Open-Hardware-Leaders/Otto-DIY/_img/portraitOfOtto.jpg

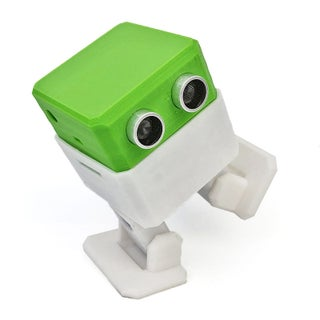
_img/portraitOfOtto.jpg
