Open-Hardware-Leaders/Otto-DIY/Papercraft/OttoDIY_masks_animals_A4.png

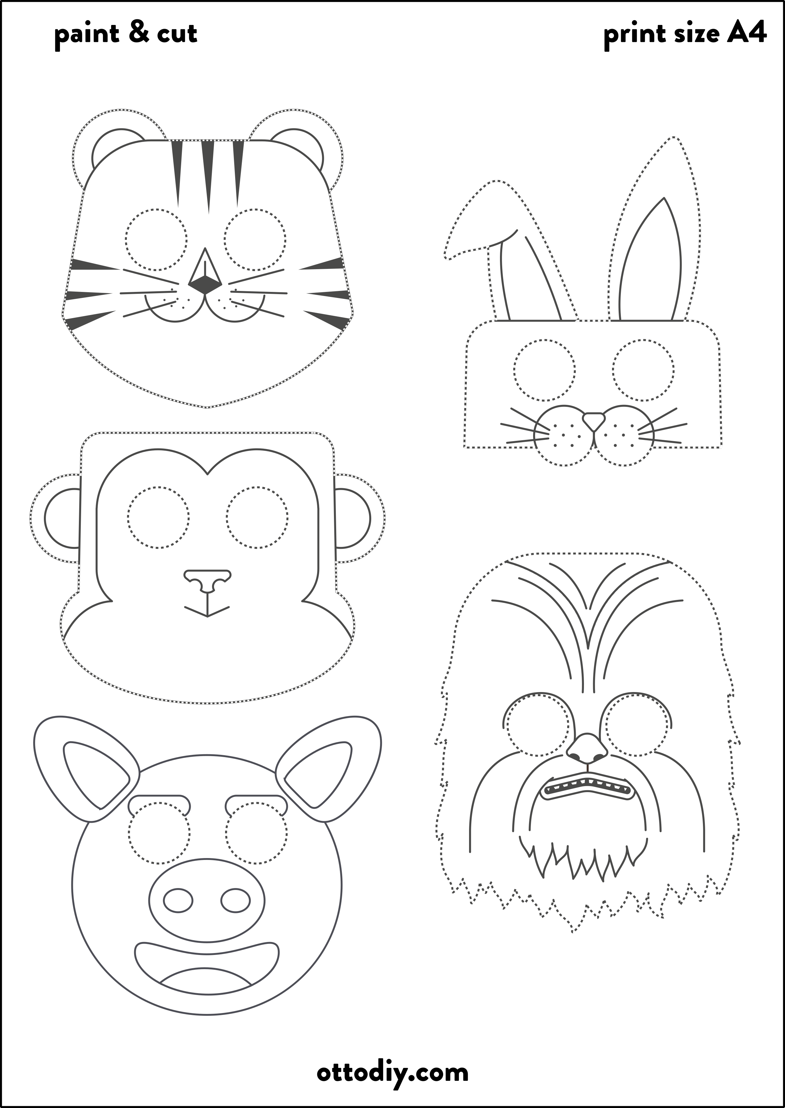
Papercraft/OttoDIY_masks_animals_A4.png
