Open-Hardware-Leaders/Otto-DIY/Papercraft/OttoDIY_masks_king_A4.png

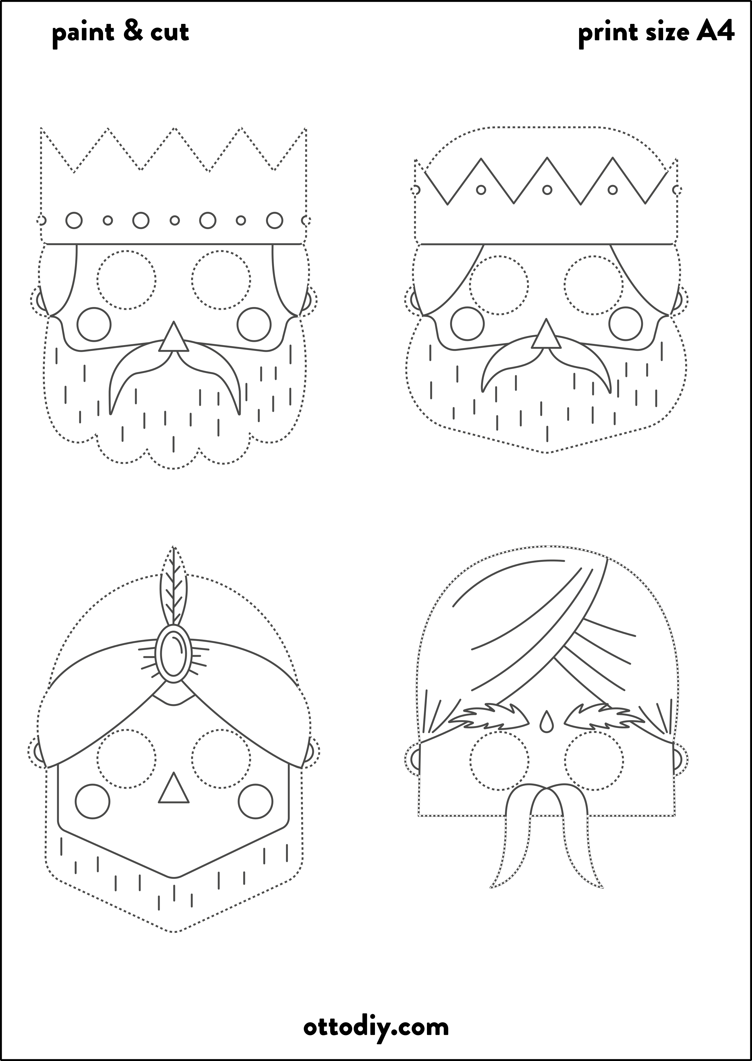
Papercraft/OttoDIY_masks_king_A4.png
