Open-Hardware-Leaders/Otto-DIY/Papercraft/OttoDIY_papercraft_krtek_A4.png

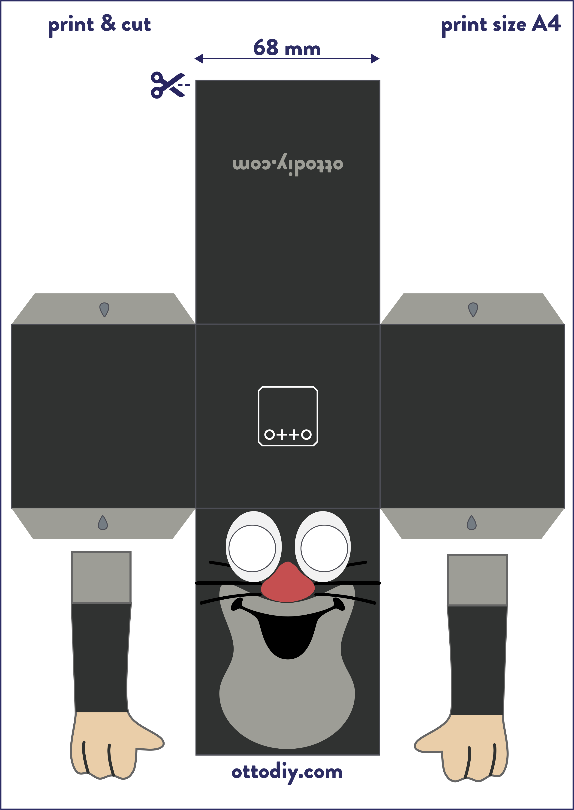
Papercraft/OttoDIY_papercraft_krtek_A4.png
