Open-Hardware-Leaders/Otto-DIY/Papercraft/OttoDIY_papercraft_milkette_A4.png

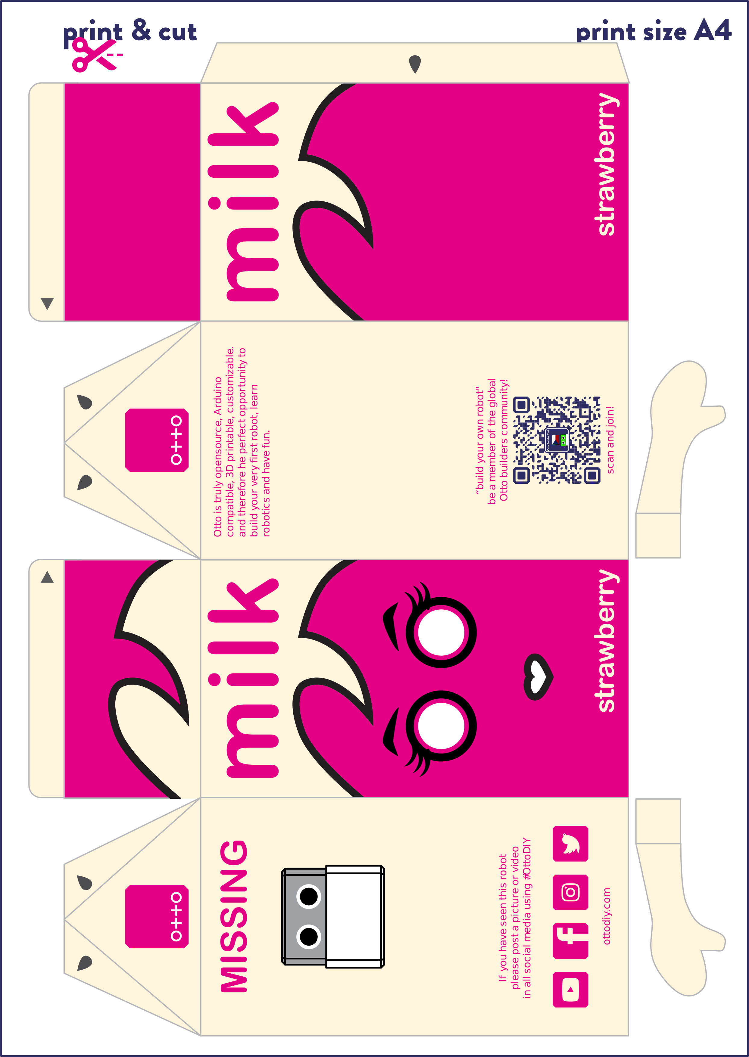
Papercraft/OttoDIY_papercraft_milkette_A4.png
