Open-Hardware-Leaders/Otto-DIY/Papercraft/OttoDIY_papercraft_minion_A4.jpg.png

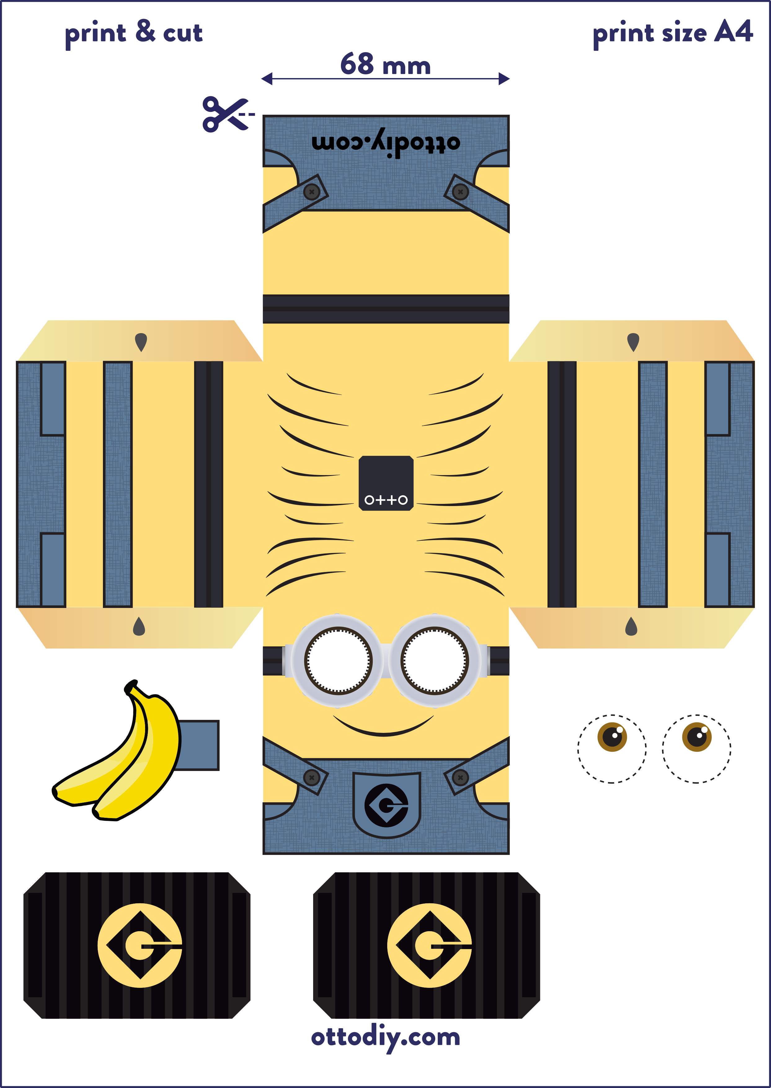
Papercraft/OttoDIY_papercraft_minion_A4.jpg.png
