Open-Hardware-Leaders/Otto-DIY/Papercraft/OttoDIY_papercraft_santa_A4.jpg

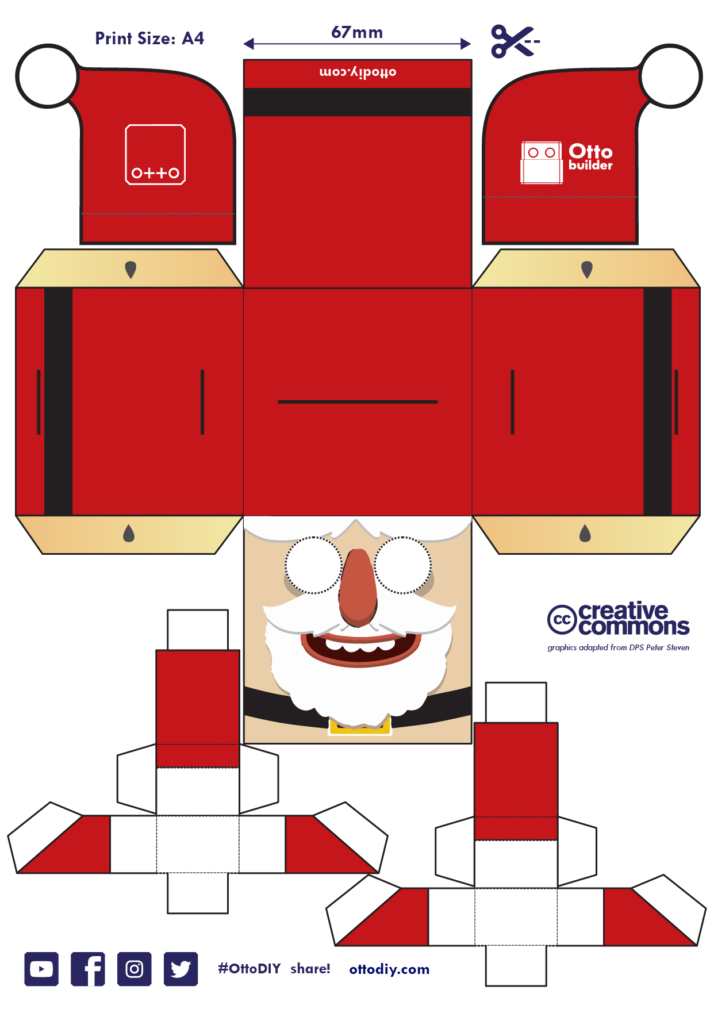
Papercraft/OttoDIY_papercraft_santa_A4.jpg
