Open-Hardware-Leaders/Otto-DIY/Papercraft/OttoDIY_papercraft_stark_A4.jpg

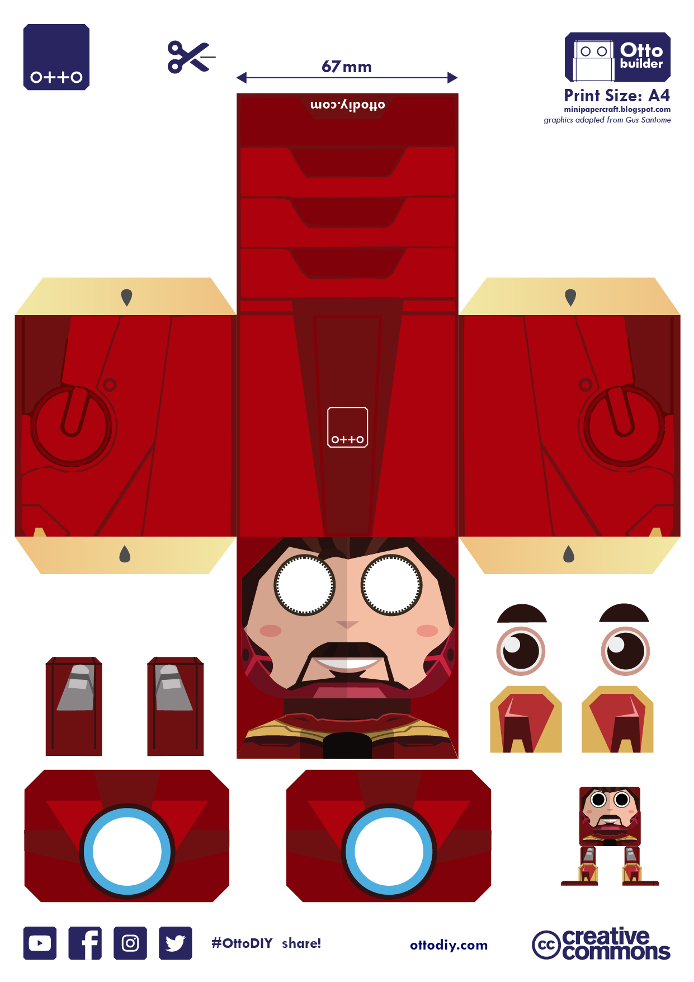
Papercraft/OttoDIY_papercraft_stark_A4.jpg
