Open-Hardware-Leaders/Otto-DIY/Papercraft/OttoDIY_papercraft_totoro_A4.png

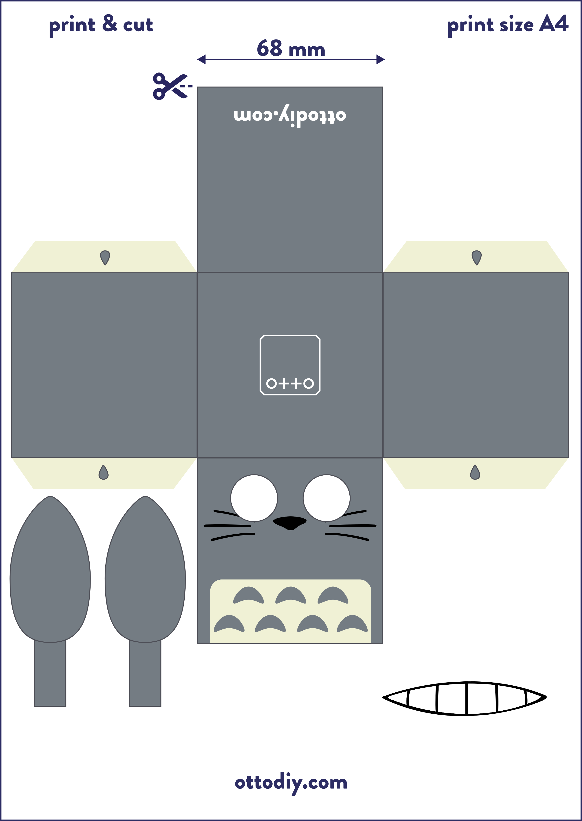
Papercraft/OttoDIY_papercraft_totoro_A4.png
