Open-Hardware-Leaders/Otto-DIY/Papercraft/OttoDIY_paperpaint _milky_A4.png

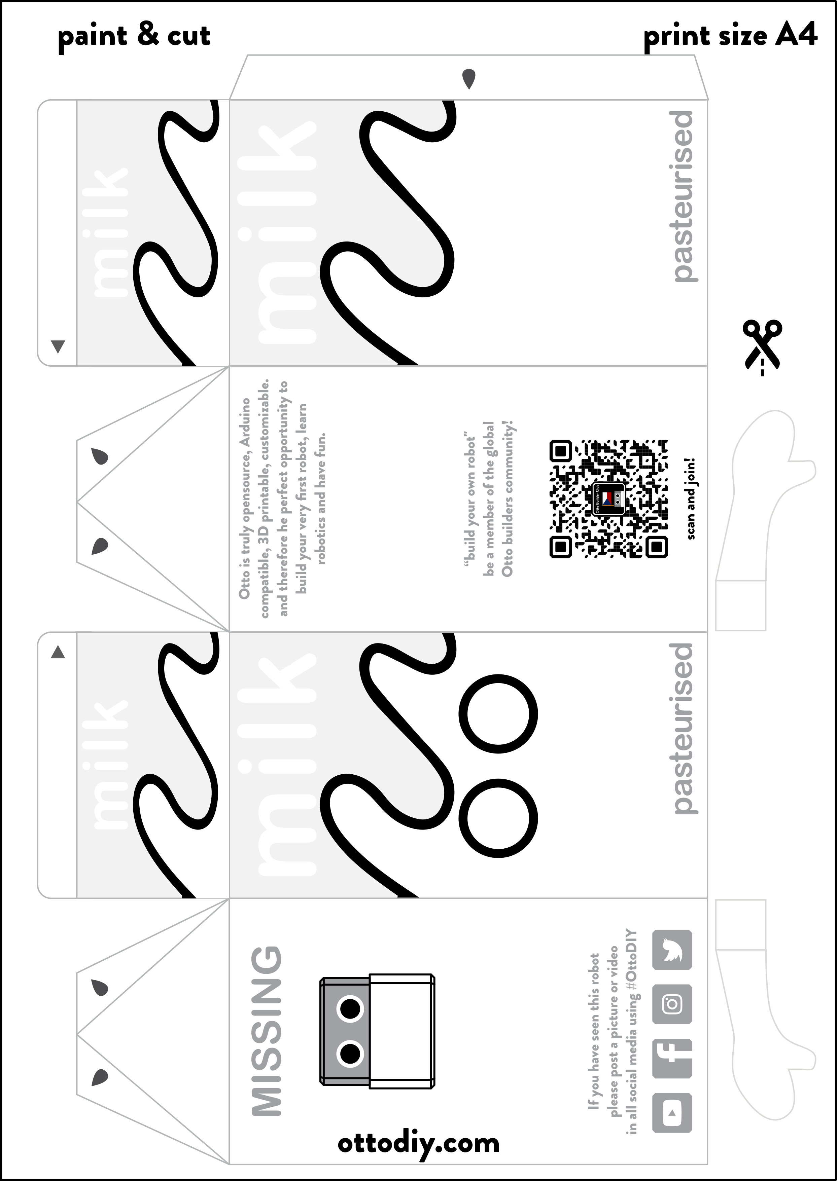
Papercraft/OttoDIY_paperpaint _milky_A4.png
