Open-Hardware-Leaders/Otto-DIY/3Dprint/OttoDIY+_Leg_V9.stl

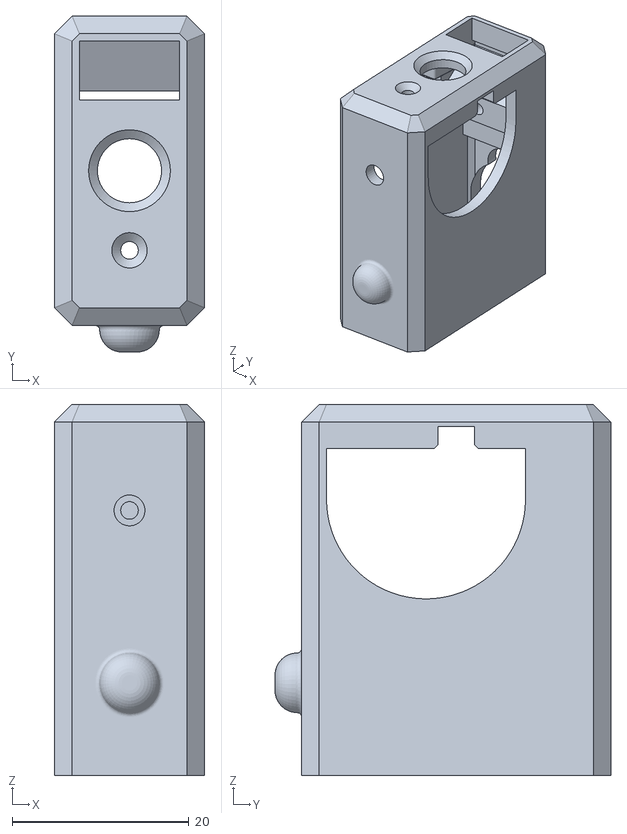
[picture p24: CAD file, 2020-02-19]
3Dprint/OttoDIY+_Leg_V9.stl
17.0 x 38.0 x 42.0
