Open-Hardware-Leaders/Otto-DIY/3Dprint/OttoDIYH_body_V04.stl

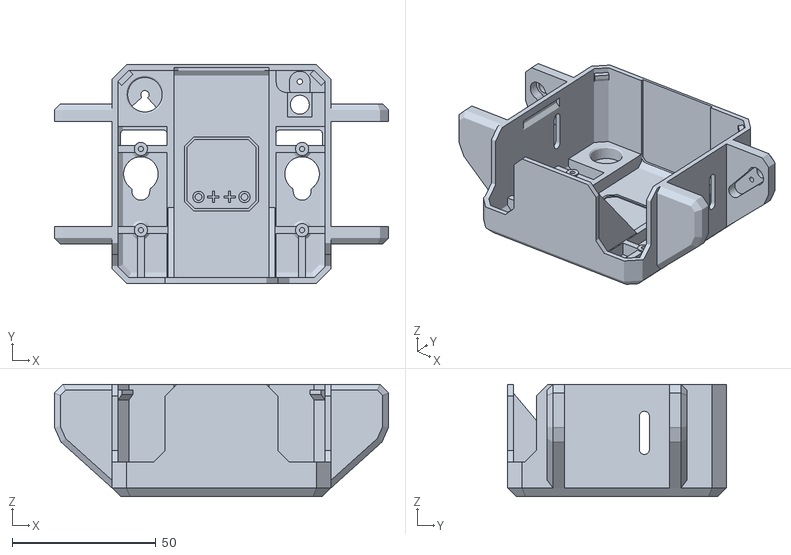
[picture p25: CAD file, 2020-02-19]
3Dprint/OttoDIYH_body_V04.stl
116.0 x 76.0 x 39.0
