Open-Hardware-Leaders/Otto-DIY/3Dprint/OttoDIYEYES_head_V04.stl

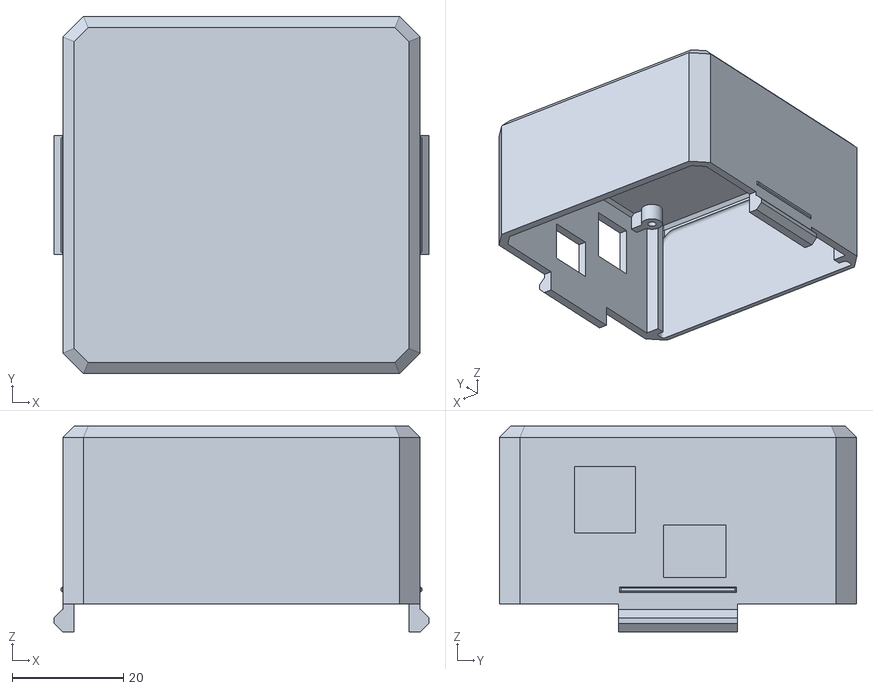
[picture p26: CAD file, 2020-02-19]
3Dprint/OttoDIYEYES_head_V04.stl
67.5 x 64.3 x 37.0
