Open-Hardware-Leaders/Otto-DIY/3Dprint/OttoDIYH_head_v06_PLUG.stl

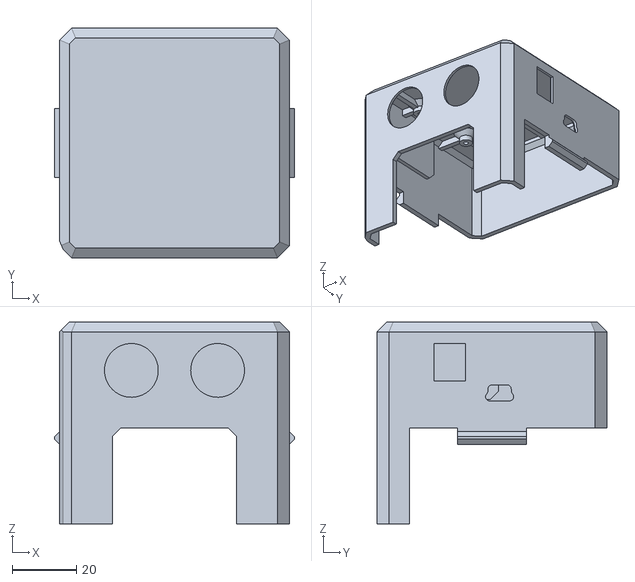
[picture p27: CAD file, 2020-02-19]
3Dprint/OttoDIYH_head_v06_PLUG.stl
74.7 x 71.5 x 62.8
