Open-Hardware-Leaders/Otto-DIY/3Dprint/switch_button_0.5.stl

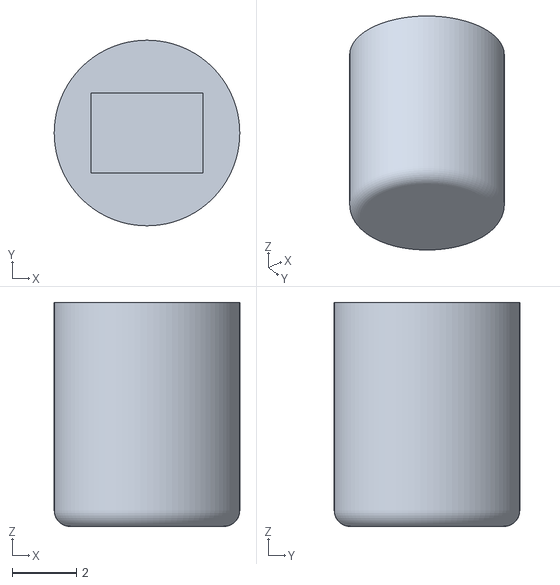
[picture p28: CAD file, 2020-02-19]
3Dprint/switch_button_0.5.stl
5.80 x 5.80 x 7.00
