Open-Hardware-Leaders/Otto-DIY/3Dprint/OttoDIY+_body_V9.stl

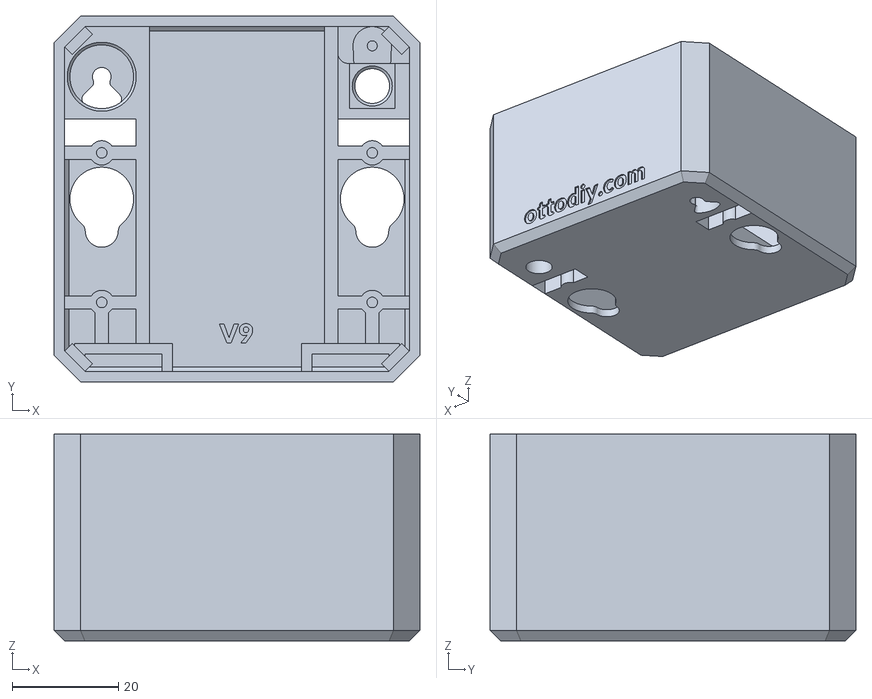
[picture p29: CAD file, 2020-02-19]
3Dprint/OttoDIY+_body_V9.stl
69.0 x 69.0 x 39.0
