Open-Hardware-Leaders/Otto-DIY/3Dprint/OttoDIY+_head_V9.stl

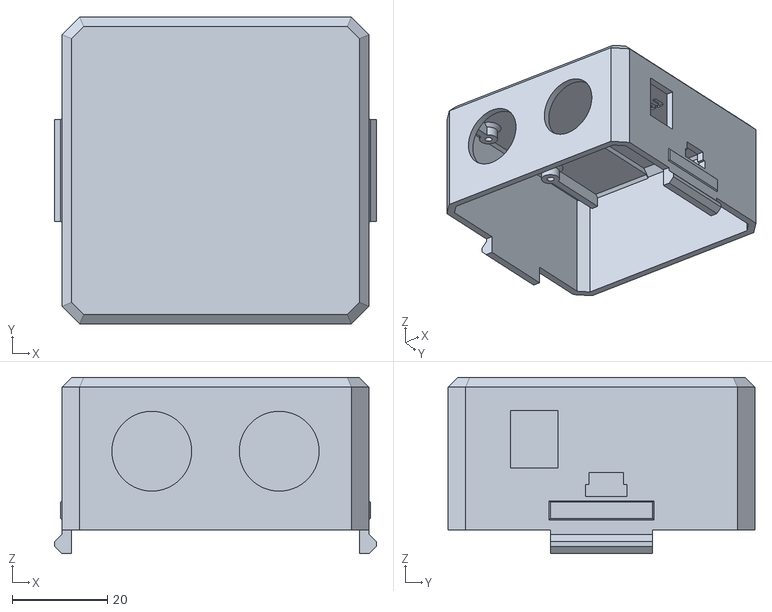
[picture p30: CAD file, 2020-02-19]
3Dprint/OttoDIY+_head_V9.stl
67.6 x 64.4 x 37.0
