Open-Hardware-Leaders/Otto-DIY/3Dprint/OttoDIY+_foot_V9.stl

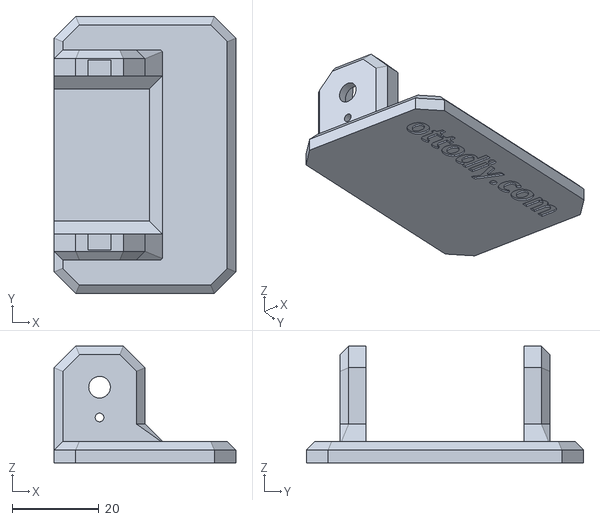
[picture p31: CAD file, 2020-02-19]
3Dprint/OttoDIY+_foot_V9.stl
42.0 x 64.0 x 27.0
