Open-Hardware-Leaders/Otto-DIY/3Dprint/OttoDIYH_grip_V04.stl

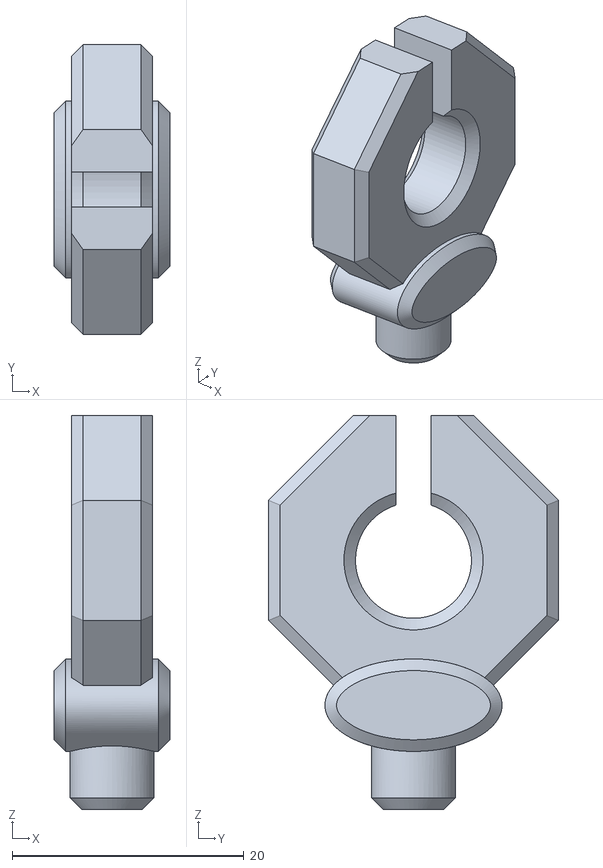
[picture p32: CAD file, 2020-02-19]
3Dprint/OttoDIYH_grip_V04.stl
10.0 x 25.0 x 34.0
