Open-Hardware-Leaders/Otto-DIY/(list of files, cad)

Other CAD files:
CAD/OttoDIY_CUSTOM.scad
CAD/OttoDIY_v09.f3z
