Open-Hardware-Leaders/Otto-DIY/How to guides/how to do a Otto DIY Workshop.pdf

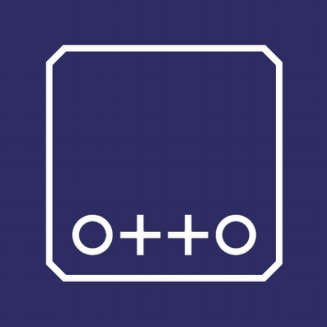
[picture p33: figure]

# Otto DIY workshop

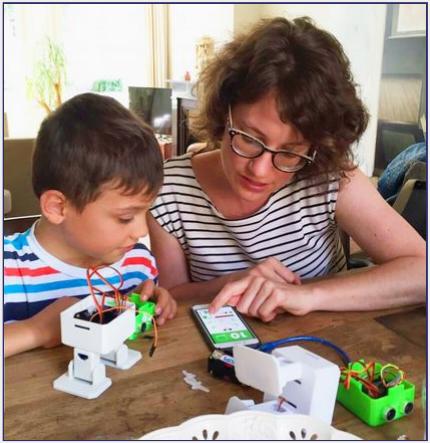
[picture p34: figure]

1) general objectives.
2) pedagogical objectives.

### 3) what do I need to define?

4) list of activities.
5) definition of activities.
6) recommendations.
7) basic use of Otto .

### 8) FAQ (frequently asked questions)

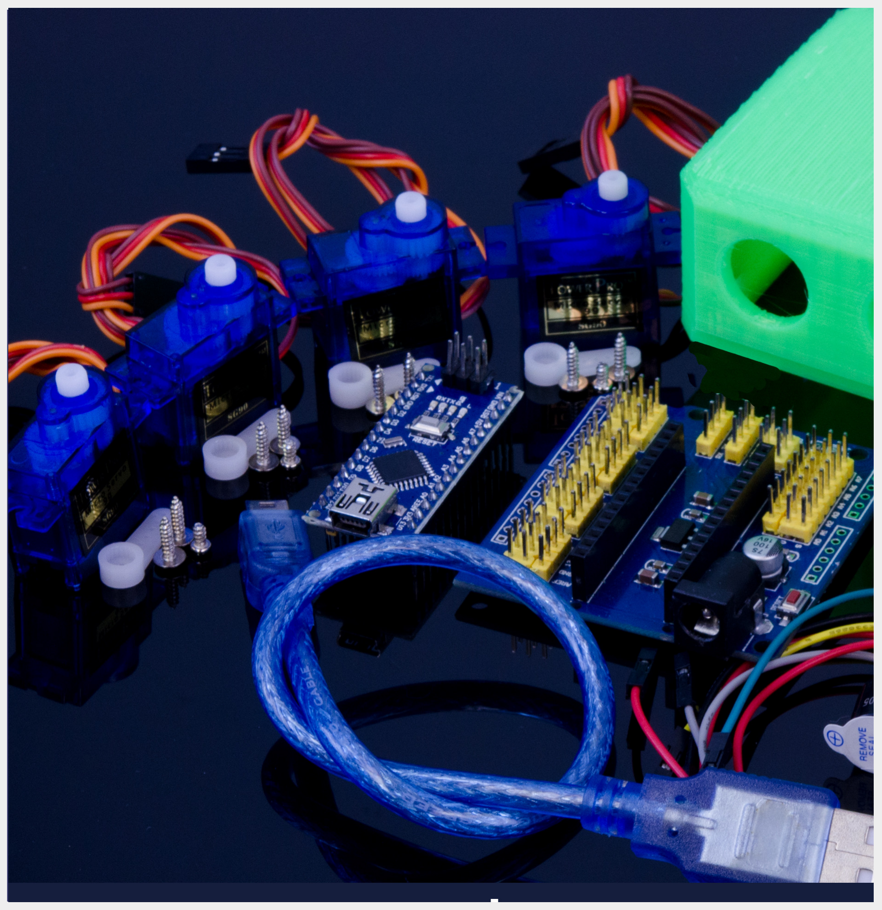
[picture p35: figure]

# general objectives

- increase curiosity about, electronics and products.

### - arouse interest in Otto and its

entertainment possibilities.

### - acquire transverse learning, such as environmental education or discovery of the world through

Otto.

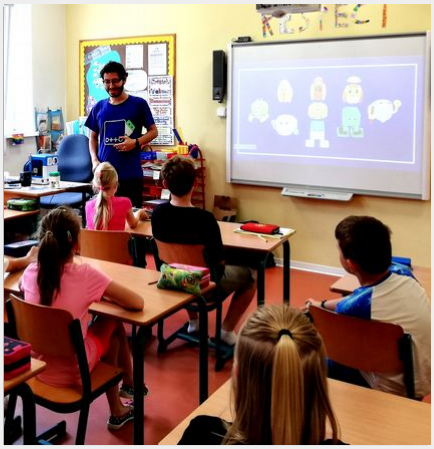
[picture p36: figure]

# pedagogical objectives

- discover Otto's possibilities.
- use educational technology.

### - learn programming with blocks

- improve sequential thinking.

### - brainstorm of improving Otto by

adding more components.
- customize your Otto.

## objectives # participants

## time for preparation

## date age group / level logistic

## robot kits / materials

what do we need to define? | costs

## location

| teachers
| duration
rest and catering | pedagogy

## content

buy robot kits in: ottodiy.com

## list of activities

## ■ intro to the workshop ■ what is a robot? ■ parts of a robot ■ basic concepts ■ build your own robot ■ code your own robot ■ troubleshooting & debugging

## duration

## ■ 5 minutes ■ 10 minutes ■ 10 minutes ■ 15 minutes ■ 60 minutes ■ 15 minutes ■ 5 minutes

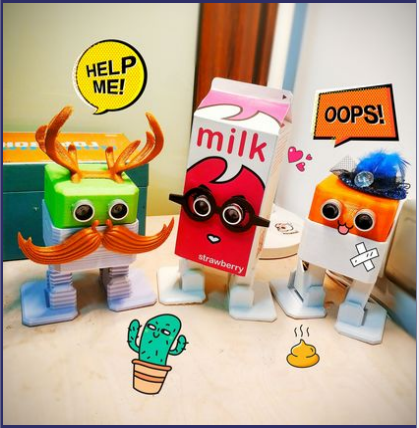
[picture p37: figure]

# definition of activities

### - open question: what is a robot?

- explain what a robot really is.

### - what objects or toys they know are electronic products? - conclusion of what we have

learned about robots.

### - have we changed our point of view?

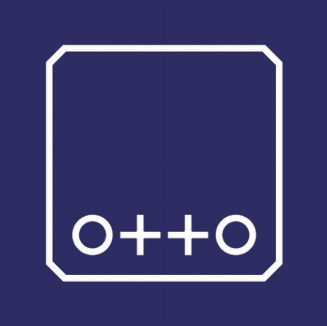
[picture p38: figure]

# what is a robot?

## arm

## car

## Otto

## toy

## truck

## drone

## humanoid cleaner

## space rover

## pet

## plane

## assistant

## machine

Czech word, robota,

# meaning “forced labor”

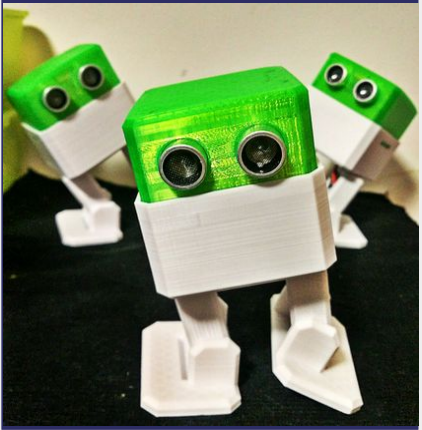
[picture p39: figure]

a robot...
the word robot many times when we hear it, we imagine a human shaped machine that walks, talk, make gestures ... but it's really something much simpler.
a robot is an automatic machine programmable that is able to interpret physical media information to modify its behavior. It has the ability to interact with the environment and, depending on that, perform some functions or others.

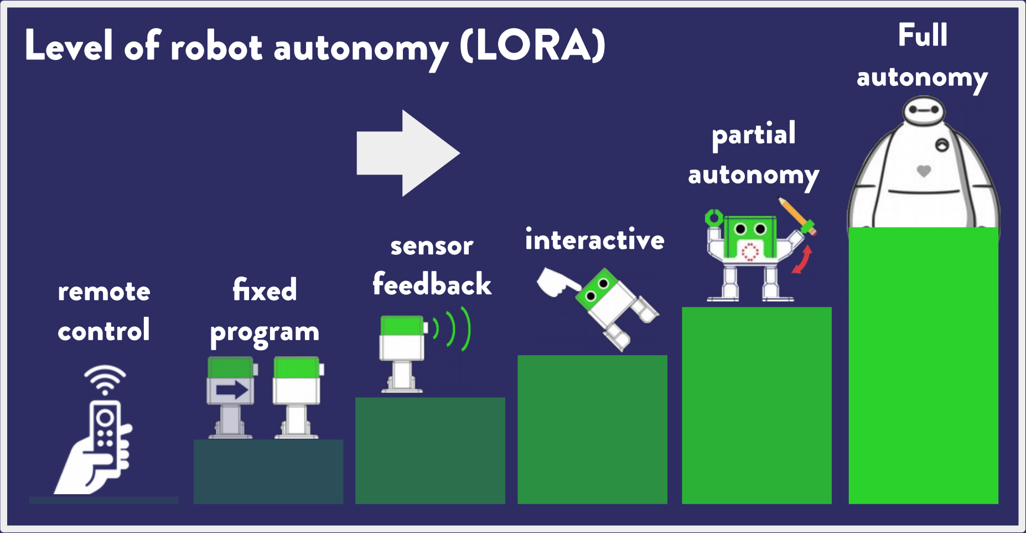
[picture p40: figure]
Level of robot autonomy (LORA); remote control; fixed program; sensor interactive feedback; Full autonomy; partial autonomy

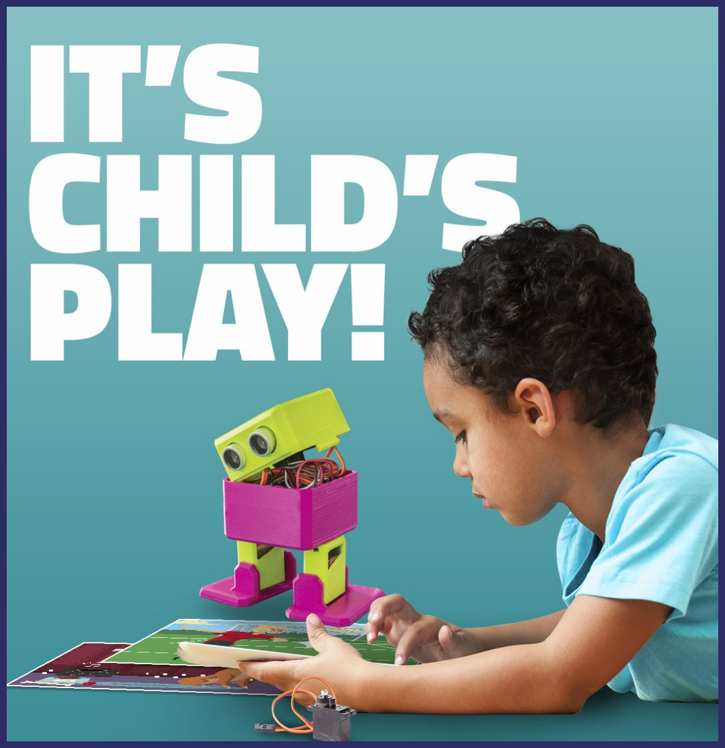
[picture p41: figure]

from the 3rd level (sensor feedback) we could be really talking about a robot, although not all the world agrees... it's not very well defined when a machine is or ceases to be Robot.
we could define robot as a machine that interacts with the environment and also helps to be human in tedious or dangerous work or in Otto´s case, on his mission of teach technology and having fun.

# parts of a robot

### - we learn to differentiate between

sensors and actuators.

### (inputs vs outputs) - where is the brain of the robot? - what is a servomotor? - can Otto talk? - how does Otto see?

- other components & interactions.

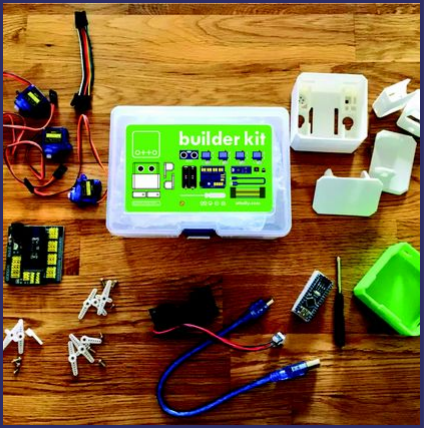
[picture p42: figure]

buy in: ottodiy.com

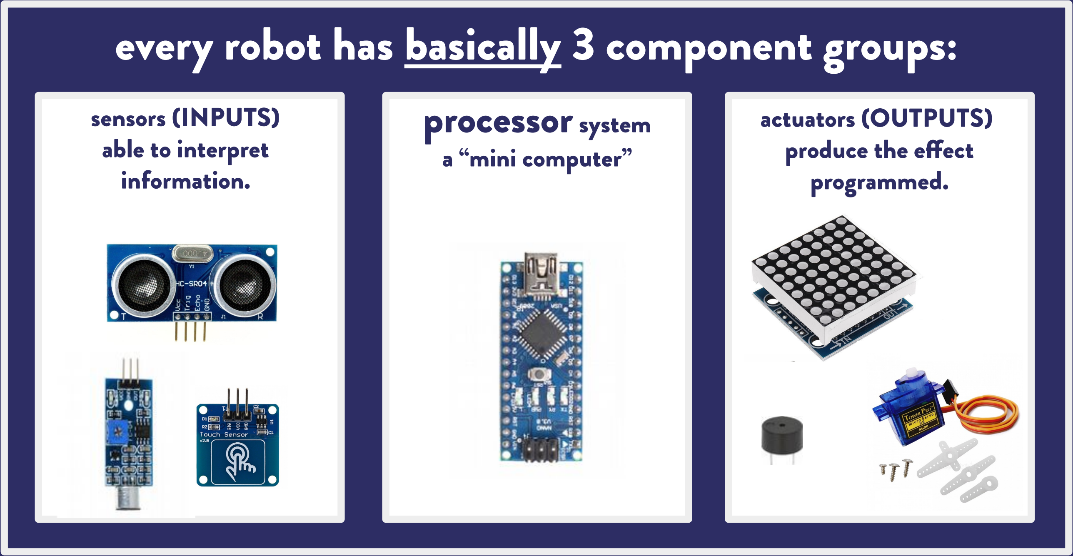
[picture p43: figure]
actuators (OUTPUTS) produce the effect programmed.; sensors (INPUTS) able to interpret information.; processor system a “mini computer”

## every robot has basically 3 component groups:

# build your own robot

time to build your Otto! make sure to follow the right instruction manual according to your kit.

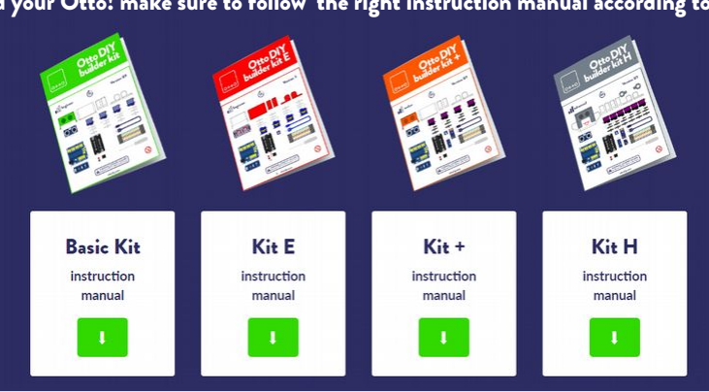
[picture p44: figure]

visit: ottodiy.com

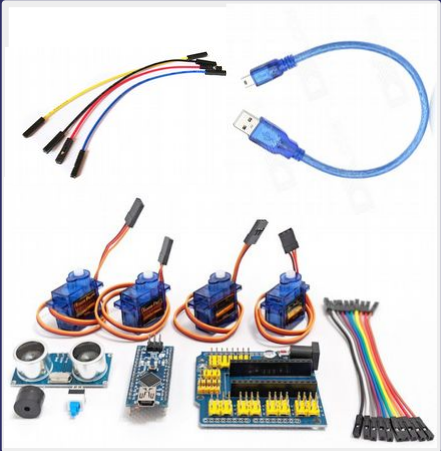
[picture p45: figure]

# precautions

- cable colors in the kit may vary, but you just have to connect to between the right pins.
- always double check, inverted polarity (short-circuit) can damage components.
- always test and power with USB cable first before using any kind of batteries.
- be gentle with the servomotors.
- 3D printed parts might need to clean them a bit specially in the screw holes.

# code your own robot

### - familiarize with the block

programming environment.
- first a simple project,
programming a dance with Otto.

### - learn the concept of sequential

thinking.

### - make a complicated project, Otto

must carry out a determined action.

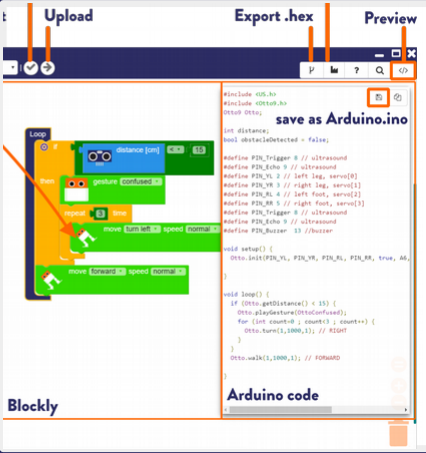
[picture p46: figure]

install the software with the examples in: https://www.ottodiy.com/#blockly

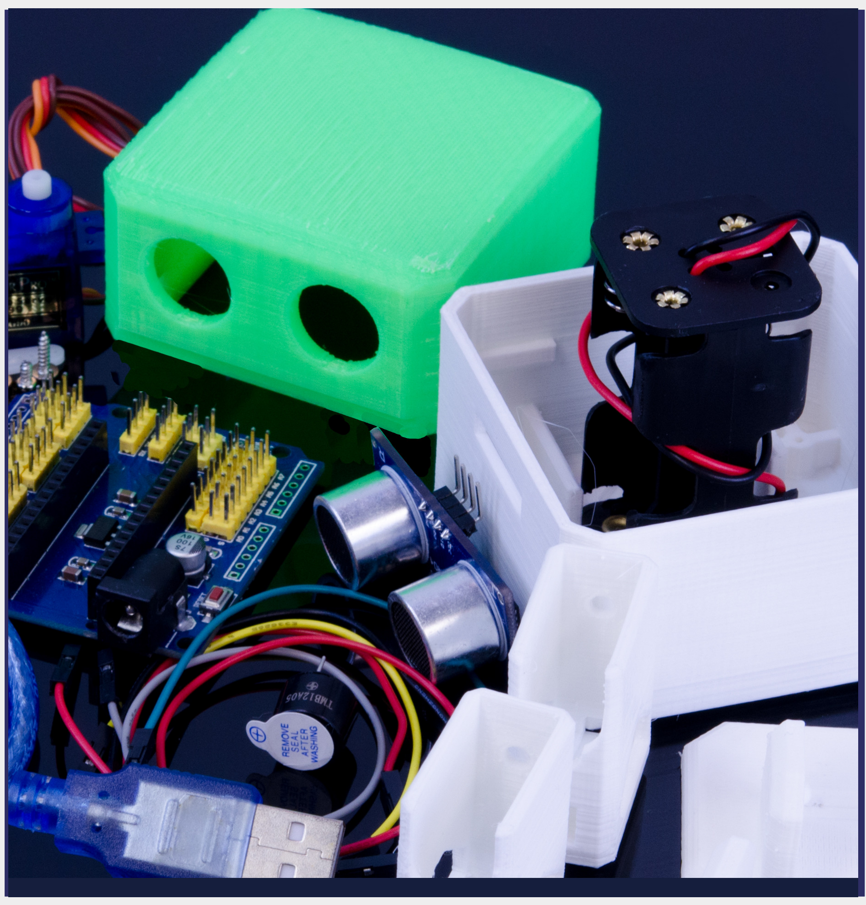
[picture p47: figure]

# recommendations

- check that all the robots have new or fully charged batteries.
- all the documentation prepared.
- all the tools prepared.
- good sound conditions.
- enough table space to handle the materials.
- preparation time for materials in space.
- have spare batteries, USB cables and parts.
- adapt to unexpected changes in the number of children or other factors.
- assistant answering questions.

## troubleshooting & debugging

find and fix, perseverance is important.

not finding Otto connected in your PC?
install the CH340 driver to recognize USB device.

can not upload code?
check USB cable and that Bluetooth is disconnected

does Otto reset every now and then?
that is because of lack of power, discharged batteries.

are Otto legs and feet twisted?
check that you centered your servos before assembly for precise movements calibration is needed read this blog article: https://www.ottodiy.com/blog/calibration

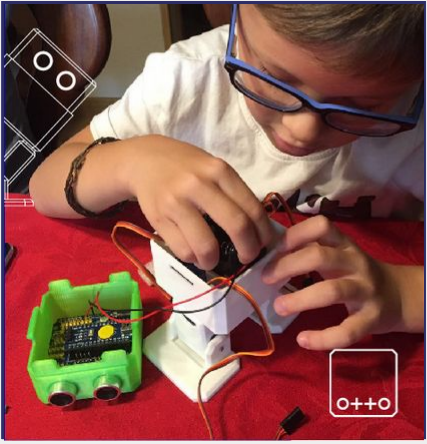
[picture p48: figure]

ask for help in the community forum : https://wikifactory.com/+OttoDIY/forum

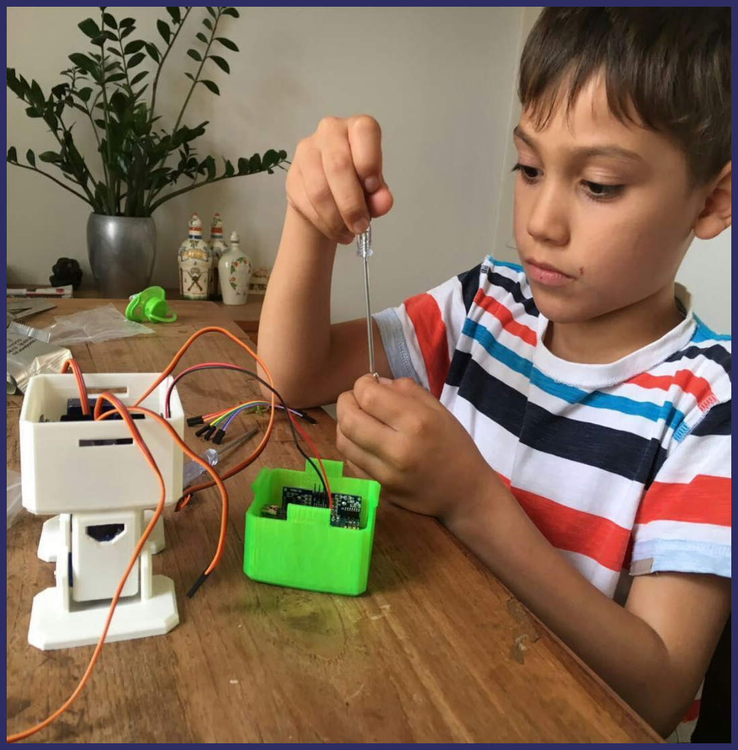
[picture p49: figure]

# FAQ (frequently asked questions)

is it hard to build?
NO, thanks to the accompanying instructions and how to videos, Otto is simple to build. how long is the battery?
4AA batteries lasts approximately 2 hours, but it depends on Otto's use and quality of battery.

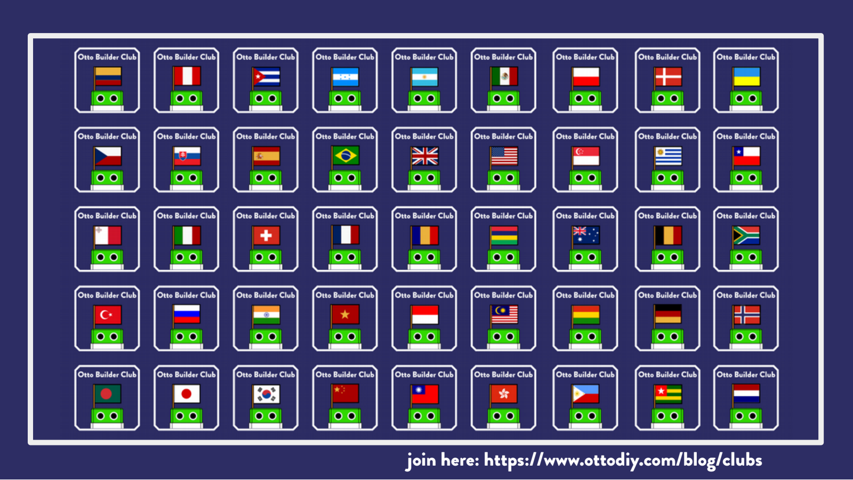
[picture p50: page 22]

join here: https://www.ottodiy.com/blog/clubs

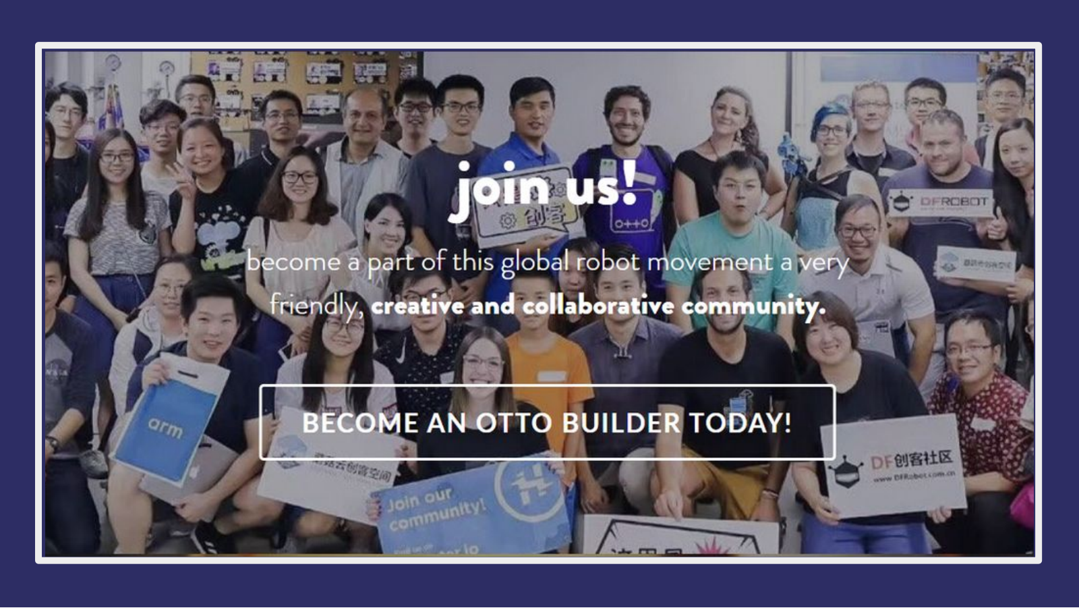
[picture p51: page 23]

1. build your own robot | (introduction)
2. code your own robot | (blocks programming basics)
3. learn to code | (advanced blocks, conditionals and compare Arduino)
4. learn to really code | (Arduino basics, C/C++, inputs, outputs)
5. create your own dance for Otto | (apply all learned)
6. what is inside Otto? | (learn electronics basics and wiring with Fritzing)
7. play with sensors | (experimentation, action - reaction)
8. design your own robot | (paper-craft with Inkscape and TinkerCAD basics)
9. make your own accessories | (basic of 3D printing or other creative decorations)

### 10. document your new Otto REMIX (Presentation and showcase!)

## additional STEAM education lessons:

reach to us for more content : https://www.ottodiy.com/

# thanks!

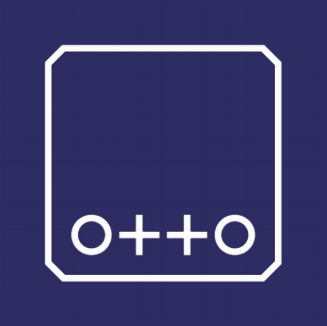
[picture p52: figure]

# ottodiy.com
