Open-Hardware-Leaders/Otto-DIY/How to guides/OttoDIY_brand2019.pdf

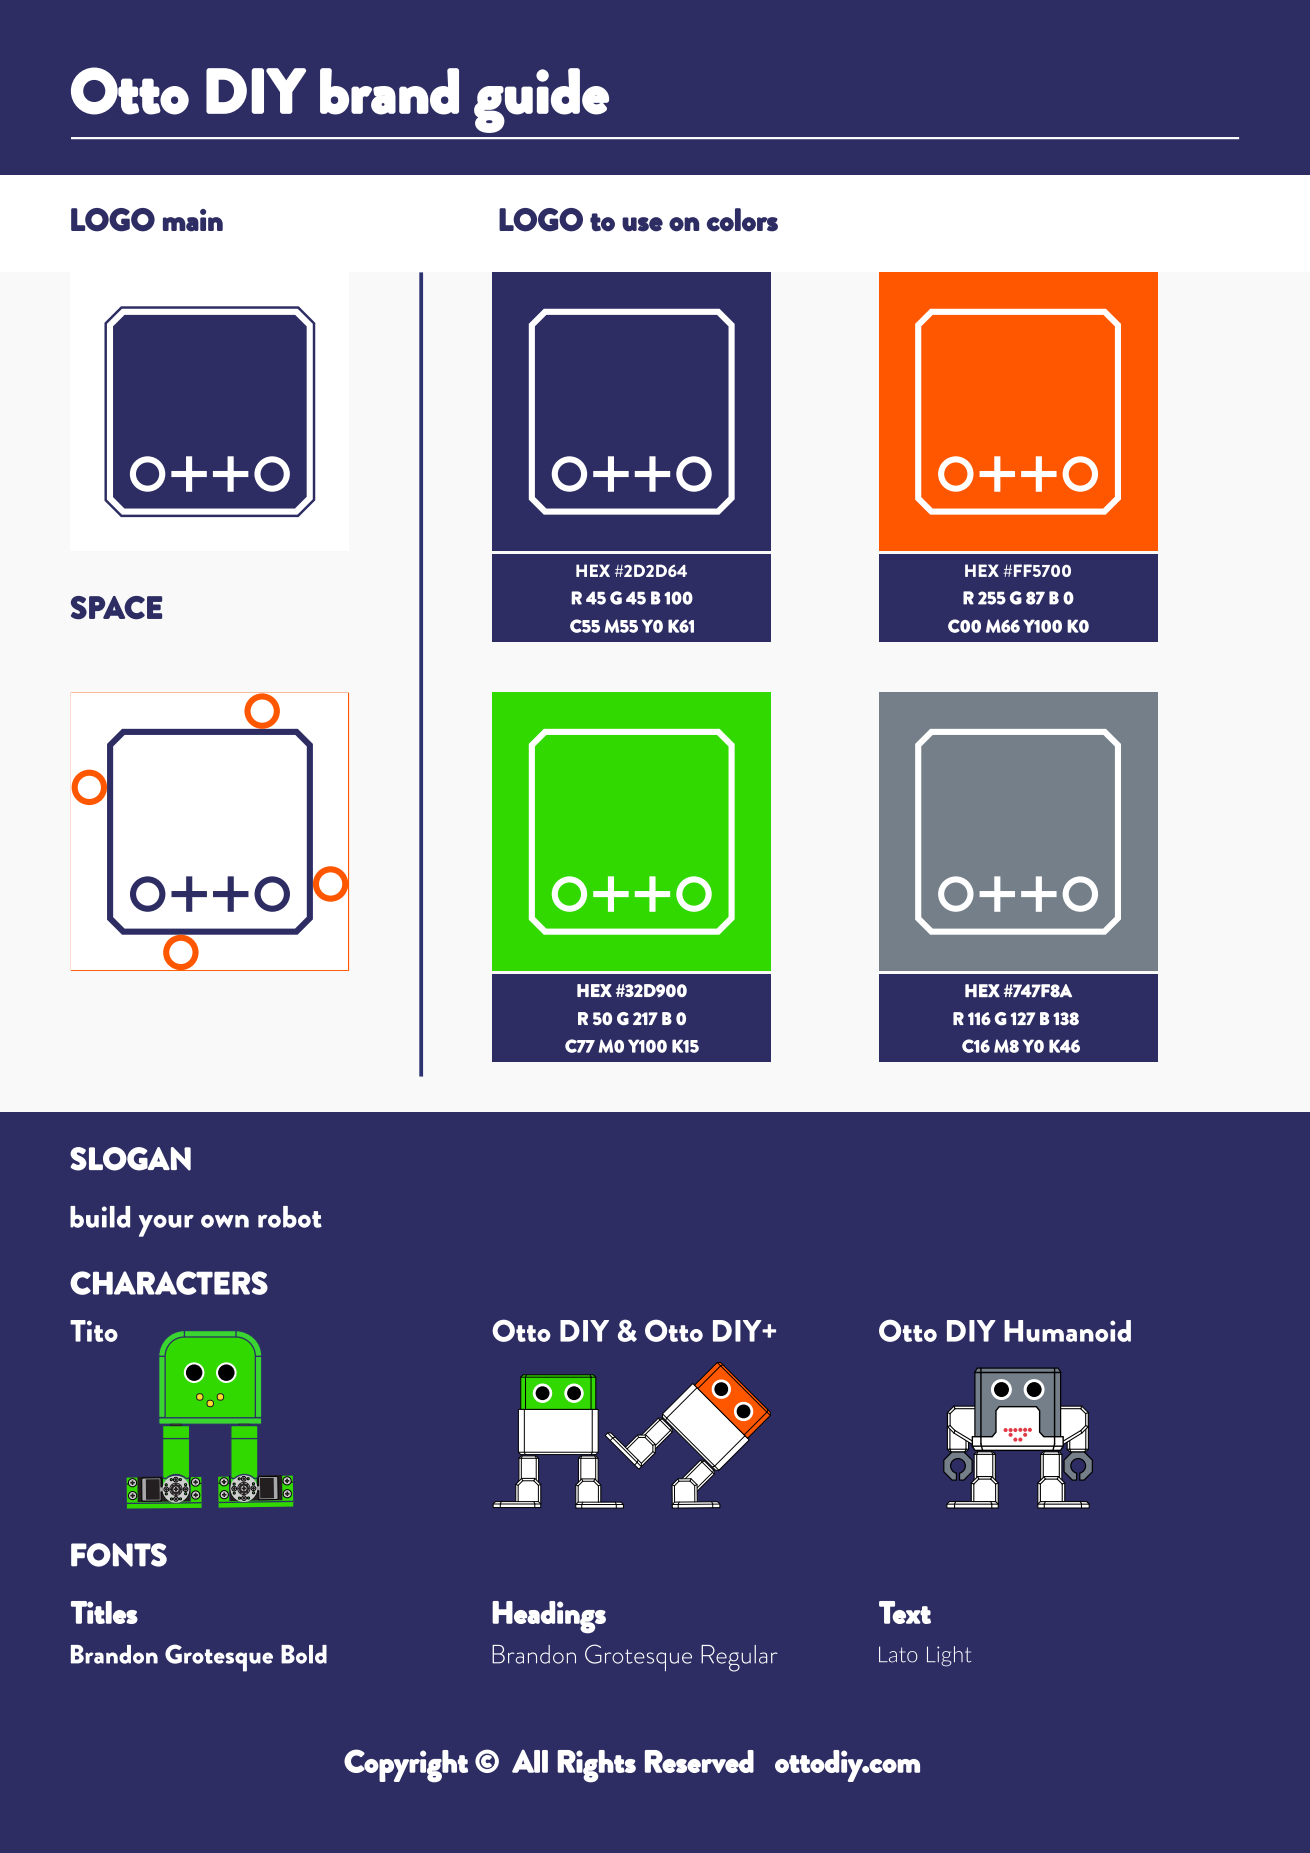
[picture p55: page 1]
