Open-Hardware-Leaders/Otto-DIY/Code/matrix/OttoH_gamesnake_V9/schematic.sch

## EAGLE design Code/matrix/OttoH_gamesnake_V9/schematic.sch (2020-02-19)

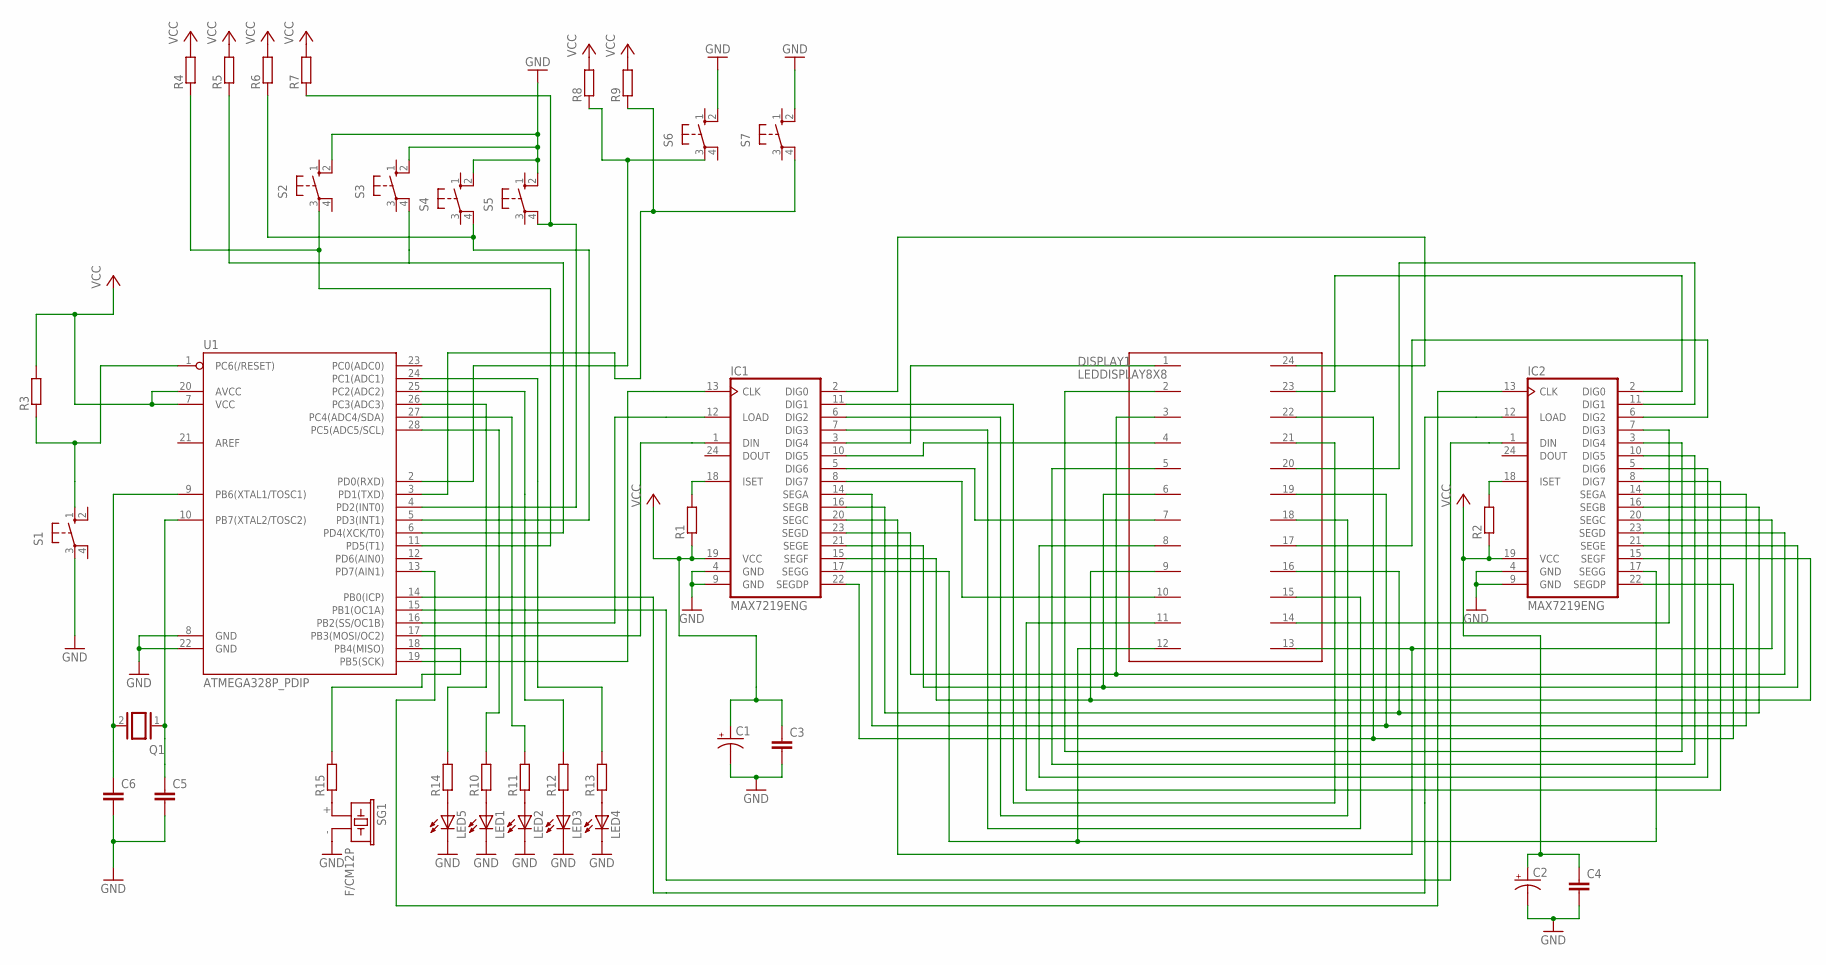
[picture p56: schematic schematic.sch]

Parts:
C1, C2: CPOL-USE2.5-6; E2,5-6
C3, C4, C5, C6: C-EU025-024X044; C025-024X044
DISPLAY1: LEDDISPLAY8X8
IC1, IC2: MAX7219ENG; DIL24-3
LED1, LED2, LED3, LED4, LED5: LED5MM
Q1: XTAL; Q
R1, R2, R3, R4, R5, R6, R7, R8, R9, R10, R11, R12, R13, R14, R15: R-EU_0204/7; 0204/7
S1: 10-XX; B3F-10XX
S2, S3, S4, S5, S6, S7: 40-XX; B3F-40XX
SG1: F/CM12P
U1: ATMEGA328P_PDIP; DIL28-3

Connections:
GND: C1.-, C2.-, C3.2, C4.2, C5.2, C6.2, IC1.4 (GND), IC1.9 (GND), IC2.4 (GND), IC2.9 (GND), LED1.K (C), LED2.K (C), LED3.K (C), LED4.K (C), LED5.K (C), S1.3, S2.2 (S1), S3.2 (S1), S4.2 (S1), S5.2 (S1), S6.2 (S1), S7.2 (S1), SG1.- (2), U1.8 (GND), U1.22 (GND)
unnamed: R15.2, U1.18 (PB4(MISO))
unnamed: DISPLAY1.19, IC1.14 (SEGA), IC2.14 (SEGA)
unnamed: DISPLAY1.16, IC1.16 (SEGB), IC2.16 (SEGB)
unnamed: DISPLAY1.13, IC1.20 (SEGC), IC2.20 (SEGC)
unnamed: DISPLAY1.3, IC1.23 (SEGD), IC2.23 (SEGD)
unnamed: DISPLAY1.6, IC1.21 (SEGE), IC2.21 (SEGE)
unnamed: DISPLAY1.9, IC1.15 (SEGF), IC2.15 (SEGF)
unnamed: DISPLAY1.12, IC1.17 (SEGG), IC2.17 (SEGG)
unnamed: DISPLAY1.23, IC2.2 (DIG0)
unnamed: DISPLAY1.20, IC2.11 (DIG1)
unnamed: DISPLAY1.17, IC2.6 (DIG2)
unnamed: DISPLAY1.14, IC2.7 (DIG3)
unnamed: DISPLAY1.2, IC2.3 (DIG4)
unnamed: DISPLAY1.5, IC2.10 (DIG5)
unnamed: DISPLAY1.8, IC2.5 (DIG6)
unnamed: DISPLAY1.11, IC2.8 (DIG7)
unnamed: DISPLAY1.24, IC1.2 (DIG0)
unnamed: DISPLAY1.21, IC1.11 (DIG1)
unnamed: DISPLAY1.18, IC1.6 (DIG2)
unnamed: DISPLAY1.15, IC1.7 (DIG3)
unnamed: DISPLAY1.1, IC1.3 (DIG4)
unnamed: DISPLAY1.4, IC1.10 (DIG5)
unnamed: DISPLAY1.7, IC1.5 (DIG6)
unnamed: DISPLAY1.10, IC1.8 (DIG7)
unnamed: IC1.1 (DIN), U1.17 (PB3(MOSI/OC2))
unnamed: IC2.13 (CLK), U1.13 (PD7(AIN1))
unnamed: IC2.12 (LOAD), U1.14 (PB0(ICP))
unnamed: IC1.18 (ISET), R1.2
unnamed: IC2.18 (ISET), R2.2
unnamed: IC1.13 (CLK), U1.19 (PB5(SCK))
unnamed: IC2.1 (DIN), U1.15 (PB1(OC1A))
unnamed: IC1.12 (LOAD), U1.16 (PB2(SS/OC1B))
unnamed: R7.1, S5.4 (P1), U1.4 (PD2(INT0))
unnamed: R6.1, S4.4 (P1), U1.5 (PD3(INT1))
unnamed: R3.1, S1.1 (S), U1.1 (PC6(/RESET))
unnamed: R5.1, S3.4 (P1), U1.6 (PD4(XCK/T0))
unnamed: LED1.A, R10.1
unnamed: LED5.A, R14.1
unnamed: R14.2, U1.26 (PC3(ADC3))
unnamed: R8.1, S6.3, U1.2 (PD0(RXD))
unnamed: DISPLAY1.22, IC1.22 (SEGDP), IC2.22 (SEGDP)
unnamed: R9.1, S7.4 (P1), U1.3 (PD1(TXD))
unnamed: LED2.A, R11.1
unnamed: LED3.A, R12.1
unnamed: LED4.A, R13.1
unnamed: R13.2, U1.24 (PC1(ADC1))
unnamed: R12.2, U1.25 (PC2(ADC2))
unnamed: R11.2, U1.27 (PC4(ADC4/SDA))
unnamed: R10.2, U1.28 (PC5(ADC5/SCL))
unnamed: R15.1, SG1.+ (1)
unnamed: C5.1, Q1.1, U1.10 (PB7(XTAL2/TOSC2))
unnamed: C6.1, Q1.2, U1.9 (PB6(XTAL1/TOSC1))
unnamed: R4.1, S2.3, U1.11 (PD5(T1))
VCC: C1.+, C2.+, C3.1, C4.1, IC1.19 (VCC), IC2.19 (VCC), R1.1, R2.1, R3.2, R4.2, R5.2, R6.2, R7.2, R8.2, R9.2, U1.7 (VCC), U1.20 (AVCC)
