Open-Hardware-Leaders/Otto-DIY/Code/dance/Otto_cantstopthefelling_V9/Otto_cantstopthefelling_V9.ino

//----------------------------------------------------------------
//-- Otto Dance Can't Stop The Feeling by Ada Sarp Şahin
//-- Made for Otto DIY project
//-----------------------------------------------------------------
#include <Servo.h>
#include <US.h>
#include <Oscillator.h>
#include <Otto9.h>
Otto9 Otto;

void setup() {
  Otto.init(2, 3, 4, 5, true, A6, 13, 8, 9); //Set the servo pins and ultrasonic pins and Buzzer pin
  Otto.sing(S_connection); //Otto wake up!
  Otto.home();
  delay(50);
}

void loop() {
  Otto.swing(4,1000,30);
  delay(400);
  Otto.updown(3,1000,30);
  delay(500);
  Otto.swing(4,1000,30);
  delay(400);
  Otto.updown(3,1000,30);
  Otto.home();
  delay(1000);
  Otto.crusaito(1,1000,30,1);
  Otto.crusaito(1,1000,30,-1);
  Otto.crusaito(1,1000,30,1);
  Otto.crusaito(1,1000,30,-1);
  Otto.flapping(1,1000,30,1);
  Otto.flapping(1,1000,30,-1);
  Otto.home();
  Otto.jump(1,700);
  Otto.crusaito(1,1000,30,1);
  Otto.crusaito(1,1000,30,-1);
  Otto.crusaito(1,1000,30,1);
  Otto.crusaito(1,1000,30,-1);
  Otto.flapping(1,1000,30,1);
  Otto.flapping(1,1000,30,-1);
  Otto.home();
  Otto.jump(1,700);
  Otto.home();
  Otto.jump(1,1000);
  Otto.moonwalker(1,2000,30,1);
  Otto.moonwalker(1,2000,30,-1);
  Otto.moonwalker(1,2000,30,1);
  Otto.moonwalker(1,2000,30,-1);
  Otto.moonwalker(1,2000,30,1);
  Otto.ascendingTurn(2,2000,30);
  delay(1500);
  Otto.home();
  Otto.crusaito(1,1000,30,1);
  Otto.crusaito(1,1000,30,-1);
  Otto.crusaito(1,1000,30,1);
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
  Otto.walk(2,1000,1);
  Otto.updown(2,1000,30);
  Otto.walk(2,1000,-1);
  Otto.jitter(4,1000,30);
  Otto.updown(2,1000,30);
  Otto.walk(2,1000,1);
  Otto.updown(2,1000,30);
  Otto.walk(2,1000,-1);
  Otto.home();
  Otto.updown(4,1000,30);
  Otto.home();
  delay(100000);
}
