Open-Hardware-Leaders/Otto-DIY/Code/dance/Otto_ucanttouchthis_V9/Otto_ucanttouchthis_V9.ino

//----------------------------------------------------------------
//-- Otto Dance U Can't Touch This by Ada Sarp Şahin
//-- Made for Otto DIY project
//-----------------------------------------------------------------
#include <US.h>
#include <Oscillator.h>
#include <Otto9.h>
#include <Servo.h>
Otto9 Otto;


void setup() {
  Otto.init(2, 3, 4, 5, true, A6, 13, 8, 9); //Set the servo pins and ultrasonic pins and Buzzer pin
  Otto.sing(S_connection); //Otto wake up!
  Otto.home();
  delay(50);
}

void loop() {
  Otto.moonwalker(1,950,30,1);
  Otto.moonwalker(1,950,30,-1);
  Otto.moonwalker(1,950,30,1); 
  delay(150);
  Otto.home();
  Otto.moonwalker(1,1000,30,1);
  Otto.moonwalker(1,1000,30,-1);
  Otto.moonwalker(1,1000,30,1); 
  delay(150);
  Otto.home();
  Otto.swing(3,1000,30);
  delay(150);
  Otto.home();
  Otto.swing(3,1000,30);
  Otto.home();
  Otto.ascendingTurn(8,870,30);
  Otto.home();
  Otto.jitter(8,900,30);
  Otto.moonwalker(1,950,30,1);
  Otto.moonwalker(1,950,30,-1);
  Otto.moonwalker(1,950,30,1); 
  delay(150);
  Otto.home();
  Otto.moonwalker(1,950,30,1);
  Otto.moonwalker(1,950,30,-1);
  Otto.moonwalker(1,950,30,1); 
  delay(150);
  Otto.home();
  Otto.swing(3,1000,30);
  delay(150);
  Otto.home();
  Otto.swing(3,1000,30);
  Otto.home();
  Otto.ascendingTurn(8,870,30);
  Otto.home();
  Otto.jitter(8,900,30);
  Otto.moonwalker(1,950,30,1);
  Otto.moonwalker(1,950,30,-1);
  Otto.moonwalker(1,950,30,1); 
  delay(150);
  Otto.home();
  Otto.moonwalker(1,950,30,1);
  Otto.moonwalker(1,950,30,-1);
  Otto.moonwalker(1,950,30,1); 
  delay(150);
  Otto.home();
  Otto.swing(3,1000,30);
  delay(150);
  Otto.home();
  Otto.swing(3,1000,30);
  Otto.home();
  Otto.ascendingTurn(8,870,30);
  Otto.home();
  Otto.jitter(8,900,30);
  Otto.moonwalker(1,950,30,1);
  Otto.moonwalker(1,950,30,-1);
  Otto.moonwalker(1,950,30,1); 
  delay(150);
  Otto.home();
  Otto.moonwalker(1,950,30,1);
  Otto.moonwalker(1,950,30,-1);
  Otto.moonwalker(1,950,30,1); 
  delay(150);
  Otto.home();
  Otto.swing(3,1000,30);
  delay(150);
  Otto.home();
  Otto.swing(3,1000,30);
  delay(150);
  Otto.home();
  Otto.updown(8,870,30);
  Otto.tiptoeSwing(7,900,30);
  delay(150);
  Otto.home();
  Otto.ascendingTurn(8,870,30);
  delay(100);
  Otto.jitter(8,900,30);
  delay(500);
  Otto.moonwalker(1,950,30,1);
  Otto.moonwalker(1,950,30,-1);
  Otto.moonwalker(1,950,30,1); 
  delay(150);
  Otto.home();
  Otto.moonwalker(1,950,30,1);
  Otto.moonwalker(1,950,30,-1);
  Otto.moonwalker(1,950,30,1); 
  delay(150);
  Otto.home();
  Otto.swing(3,1000,30);
  delay(150);
  Otto.home();
  Otto.swing(3,1000,30);
  delay(150);
  Otto.home();
  Otto.updown(8,870,30);
  Otto.tiptoeSwing(7,900,30);
  delay(150);
  Otto.home();
  Otto.ascendingTurn(8,870,30);
  delay(100);
  Otto.jitter(8,900,30);
  delay(500);
  Otto.moonwalker(1,950,30,1);
  Otto.moonwalker(1,950,30,-1);
  Otto.moonwalker(1,950,30,1); 
  delay(150);
  Otto.home();
  Otto.moonwalker(1,950,30,1);
  Otto.moonwalker(1,950,30,-1);
  Otto.moonwalker(1,950,30,1); 
  delay(150);
  Otto.home();
  Otto.swing(3,1000,30);
  delay(150);
  Otto.home();
  Otto.swing(3,1000,30);
  delay(150);
  Otto.home();
  Otto.updown(8,870,30);
  Otto.tiptoeSwing(7,900,30);
  delay(500);
  Otto.home();
  Otto.moonwalker(1,950,30,1);
  Otto.moonwalker(1,950,30,-1);
  Otto.moonwalker(1,950,30,1); 
  delay(150);
  Otto.home();
  Otto.moonwalker(1,1000,30,1);
  Otto.moonwalker(1,1000,30,-1);
  Otto.moonwalker(1,1000,30,1); 
  delay(150);
  Otto.home();
  Otto.swing(3,1000,30);
  delay(150);
  Otto.home();
  Otto.swing(3,1000,30);
  Otto.home();
  Otto.ascendingTurn(8,870,30);
  Otto.home();
  Otto.jitter(8,900,30);
  delay(150);
  Otto.home();
  Otto.updown(8,870,30);
  Otto.tiptoeSwing(7,900,30);
  delay(150);
  Otto.home();
  delay(10000);
}
