Open-Hardware-Leaders/Otto-DIY/(notices)

Notices in the files:
Code/calibration/OttoH_Calibrationserial_V9/OttoH_Calibrationserial_V9.ino:
it under the terms of the GNU General Public License as published by
the Free Software Foundation, either version 3 of the License, or
(at your option) any later version.
parts and their libraries:
SparkFun-DigitalIC: Licensing: CC v3.0 Share-Alike You are welcome to use this library for commercial purposes.
